koson/LinearPS/LinearPS-BOM.xlsx

Source: | F:\OneDrive\__PCB Works\LinearPS\LinearPS.kicad_sch
Date: | 2021-06-12 21:37
Tool: | Eeschema (5.99.0-10447-gf083f043cb)
Generator: | C:\Program Files\KiCad\5.99\bin\scripting\plugins/bom_csv_grouped_by_value.py
Component Count: | 102
Item | Qty | Reference(s) | Value | LibPart | Footprint | Datasheet | Description | Part_Number
1 | 2 | C1, C10 | CP | LinearPS-rescue:CP | Capacitors_THT:CP_Radial_D18.0mm_P7.50mm | http://www.es.co.th/detail.asp?Prod=056603488 | E-Cap KM Series 4700uF/50Vdc -40 C to +105 C, 20% ,2000hrs. Miniature Sized | EKM478M1HL40RRSAP
2 | 4 | C2, C3, C7, C12 | 47 uF | LinearPS-rescue:CP | Capacitors_THT:CP_Radial_D8.0mm_P5.00mm | http://www.es.co.th/detail.asp?Prod=056601120 | E-Cap GS Series 4.7uF/400Volt | EGS475M2GF12RRSAP
3 | 4 | C4, C13, C14, C16 | 100 nF | LinearPS-rescue:C | Capacitors_THT:C_Disc_D5.0mm_W2.5mm_P5.00mm | http://www.es.co.th/detail.asp?Prod=015800183 | Ceramic Disc Cap 0.1uF/50V, -20/+80% Dia 7.5mm | S104ZYFE072L
4 | 1 | C5 | 220 nF | LinearPS-rescue:C | Capacitors_THT:C_Disc_D5.0mm_W2.5mm_P5.00mm | http://www.es.co.th/detail.asp?Prod=015802865 | Ceramic Disc Cap 0.22uF/50Vdc, -20/+80%,Y5V | S224ZYFE082LF
5 | 3 | C6, C9, C15 | 100 pF | LinearPS-rescue:C | Capacitors_THT:C_Disc_D5.0mm_W2.5mm_P5.00mm | http://www.es.co.th/detail.asp?Prod=015800245 | Ceramic Disc Cap 100pF/50Vdc, 10% | T101KCHE062L
6 | 1 | C8 | 330 pF | LinearPS-rescue:C | Capacitors_THT:C_Disc_D5.0mm_W2.5mm_P5.00mm | http://www.es.co.th/detail.asp?Prod=015802125 | Ceramic Disc Cap 330pF/50Vdc, 10% | H331KYAE052A-T
7 | 4 | D1, D2, D3, D4 | 10A10 | LinearPS-rescue:D | Diodes_THT:D_P600_R-6_P12.70mm_Horizontal
8 | 5 | D5, D6, D7, D9, D23 | 1N4148 | LinearPS-rescue:D | Diodes_THT:D_DO-35_SOD27_P7.62mm_Horizontal | http://www.es.co.th/detail.asp?Prod=029901371 | Fast Switching Diodes 100V/200mA trr 4ns | PH1N4148TB
9 | 1 | D8 | 1N5339B | LinearPS-rescue:D_Zener | Diodes_THT:D_DO-41_SOD81_P7.62mm_Horizontal | http://www.es.co.th/detail.asp?Prod=013500933 | ZENER DIODE 5.6V/1.3W, Iz=45mA | 1N4734A-TAP
10 | 1 | D10 | 1N4740A | LinearPS-rescue:D_Zener | Diodes_THT:D_DO-41_SOD81_P7.62mm_Horizontal | http://www.es.co.th/detail.asp?Prod=029900847 | Zener Diodes 1W/10V , Iz= 25mA Hermetically Sealed Glass Zener Voltage Regulator | 1N4740ATA-TC/ON
11 | 1 | D11 | 1N4004 | LinearPS-rescue:D | Diodes_THT:D_DO-41_SOD81_P7.62mm_Horizontal | http://www.es.co.th/detail.asp?Prod=030800029 | Silicon Rectifiers Diode 400V/1A | 1N4004-JJ
12 | 2 | D12, D21 | LED | LinearPS-rescue:LED | LEDs:LED_D3.0mm | http://www.es.co.th/detail.asp?Prod=001000491 | LED Round 3mm,4mcd,Red Color Red Diffused Lens | TOL-30BHRADAA
13 | 1 | D22 | 1N4733A | LinearPS-rescue:D_Zener | Diodes_THT:D_DO-41_SOD81_P7.62mm_Horizontal | http://www.es.co.th/detail.asp?prod=029900727 | Zener Diodes 1W/5.1V, Iz = 49mA Hermetically Sealed Glass Zener Voltage Regulator | 1N4733ATA-TC/ON
14 | 1 | J1 | Conn_01x03 | LinearPS-rescue:Conn_01x03 | Connectors_Terminal_Blocks:TerminalBlock_bornier-3_P5.08mm
15 | 1 | J2 | Conn_01x02 | LinearPS-rescue:Conn_01x02 | Connectors_Terminal_Blocks:TerminalBlock_bornier-2_P5.08mm
16 | 2 | J3, J9 | Conn_01x04 | LinearPS-rescue:Conn_01x04 | Connectors_Molex:Molex_KK-6410-04_04x2.54mm_Straight
17 | 8 | J4, J5, J6, J7, J10, J11, J12, J14 | Conn_01x01 | LinearPS-rescue:Conn_01x01 | Connectors:1pin
18 | 1 | J8 | Conn_01x02 | LinearPS-rescue:Conn_01x02 | Connectors_Molex:Molex_KK-6410-02_02x2.54mm_Straight
19 | 3 | JP1, JP2, JP3 | Jumper_NO_Small | LinearPS-rescue:Jumper_NO_Small | Pin_Headers:Pin_Header_Straight_1x02_Pitch2.54mm
20 | 2 | JP4, JP5 | Jumper_NC_Dual | LinearPS-rescue:Jumper_NC_Dual | Pin_Headers:Pin_Header_Straight_1x03_Pitch2.54mm
21 | 1 | Q1 | 2N3904 | LinearPS-rescue:2N3904 | TO_SOT_Packages_THT:TO-92_Molded_Narrow | http://www.es.co.th/detail.asp?prod=012302944 | Transistor NPN 40V/0.2A,for General Purpose Amplifier and Switch, Useful Dynamic Range Extends to 100mA(Switch) and to 100MHz(Amplifier) | 2N3904TA
22 | 1 | Q2 | TIP41 | LinearPS-rescue:TIP41 | linearps:TO-220-3_Vertical_WithPads | http://www.es.co.th/detail.asp?prod=008304245 | Silicon Power Transistors NPN 100V/6A Medium Power Linear and Switching Applications Complementary with TIP42C | TIP41C
23 | 1 | Q3 | 2N3906 | LinearPS-rescue:2N3906 | TO_SOT_Packages_THT:TO-92_Molded_Narrow | http://www.es.co.th/detail.asp?Prod=012302600 | Transistor PNP 40V/0.2A for General Purpose Amplifier and Switching Application at Collector Currents of 10uA to 100mA | 2N3906TA
24 | 4 | Q4, Q5, Q6, Q7 | TIP41 | LinearPS-rescue:TIP41 | linearps:TO-220-3_Vertical_WithBigPads | http://www.es.co.th/detail.asp?prod=008304245 | Silicon Power Transistors NPN 100V/6A Medium Power Linear and Switching Applications Complementary with TIP42C | TIP41C
25 | 4 | R1, R9, R19, R30 | 2k2 | LinearPS-rescue:R | Resistors_THT:R_Axial_DIN0207_L6.3mm_D2.5mm_P7.62mm_Horizontal |  |  | R 2k2 1/4W 5%
26 | 1 | R2 | 82R | LinearPS-rescue:R | Resistors_THT:R_Axial_DIN0411_L9.9mm_D3.6mm_P12.70mm_Horizontal |  |  | R 82E 1W 5%
27 | 1 | R3 | 220R | LinearPS-rescue:R | Resistors_THT:R_Axial_DIN0411_L9.9mm_D3.6mm_P12.70mm_Horizontal |  |  | R 220E 1W 5%
28 | 1 | R4 | 4k7 | LinearPS-rescue:R | Resistors_THT:R_Axial_DIN0207_L6.3mm_D2.5mm_P7.62mm_Horizontal |  |  | R 4k7 1/4W 5%
29 | 10 | R5, R6, R15, R20, R21, R28, R29, R34, R36, R38 | 10k | LinearPS-rescue:R | Resistors_THT:R_Axial_DIN0207_L6.3mm_D2.5mm_P7.62mm_Horizontal |  |  | R 10k 1/4W 5%
30 | 5 | R7, R24, R25, R26, R27 | 0R47 | LinearPS-rescue:R | Resistors_THT:R_Axial_Power_L25.0mm_W6.4mm_P27.94mm |  |  | R 0R47 5W 5%
31 | 2 | R8, R11 | 27k | LinearPS-rescue:R | Resistors_THT:R_Axial_DIN0207_L6.3mm_D2.5mm_P7.62mm_Horizontal |  |  | R 27k 1/4W 5%
32 | 4 | R10, R23, R37, R39 | 100k | LinearPS-rescue:R | Resistors_THT:R_Axial_DIN0207_L6.3mm_D2.5mm_P7.62mm_Horizontal |  |  | R 100k 1/4W 5%
33 | 1 | R12 | 56k | LinearPS-rescue:R | Resistors_THT:R_Axial_DIN0207_L6.3mm_D2.5mm_P7.62mm_Horizontal |  |  | R 56k 1/4W 5%
34 | 1 | R13 | 22k | LinearPS-rescue:R | Resistors_THT:R_Axial_DIN0207_L6.3mm_D2.5mm_P7.62mm_Horizontal |  |  | R 22k 1/4W 5%
35 | 1 | R14 | 1k | LinearPS-rescue:R | Resistors_THT:R_Axial_DIN0207_L6.3mm_D2.5mm_P7.62mm_Horizontal |  |  | R 1k 1/4W 5%
36 | 3 | R16, R32, R33 | 1k | LinearPS-rescue:R | Resistors_THT:R_Axial_DIN0411_L9.9mm_D3.6mm_P12.70mm_Horizontal |  |  | R 1k 1W 5%
37 | 1 | R17 | 33R | LinearPS-rescue:R | Resistors_THT:R_Axial_DIN0207_L6.3mm_D2.5mm_P7.62mm_Horizontal |  |  | R 33R 1/4W 5%
38 | 1 | R18 | 33k | LinearPS-rescue:R | Resistors_THT:R_Axial_DIN0207_L6.3mm_D2.5mm_P7.62mm_Horizontal |  |  | R 33k 1/4W 5%
39 | 2 | R22, R31 | 3k9 | LinearPS-rescue:R | Resistors_THT:R_Axial_DIN0207_L6.3mm_D2.5mm_P7.62mm_Horizontal |  |  | R 3k9 1/4W 5%
40 | 1 | R35 | 1M | LinearPS-rescue:R | Resistors_THT:R_Axial_DIN0207_L6.3mm_D2.5mm_P7.62mm_Horizontal |  |  | R 1M 1/4W 5%
41 | 1 | R40 | 47k | LinearPS-rescue:R | Resistors_THT:R_Axial_DIN0207_L6.3mm_D2.5mm_P7.62mm_Horizontal |  |  | R 47k 1/4W 5%
42 | 2 | RV1, RV2 | 10k | LinearPS-rescue:POT | Potentiometers:Potentiometer_WirePads |  |  | Volume 10kB
43 | 1 | RV3 | 100k | LinearPS-rescue:POT | Potentiometers:Potentiometer_Trimmer_Bourns_3296W | http://www.es.co.th/detail.asp?prod=014102719 | Trimpot 25 Turns,100k, 10%, 0.5 w. | 3296W-1-104LF
44 | 1 | RV6 | 20k | LinearPS-rescue:POT | Potentiometers:Potentiometer_Trimmer_Bourns_3296W | http://www.es.co.th/detail.asp?prod=014102631 | Trimpot 25 Turns,20k,10%, 0.5 w. | 3296W-1-203LF
45 | 3 | U1, U2, U3 | LM358 | LinearPS-rescue:LM358 | Housings_DIP:DIP-8_W7.62mm_Socket | http://www.es.co.th/detail.asp?Prod=008607238 | Dual Op-Amp,Unity Gain Bandwidth 700kHz Slew Rate 0.3V/us,Input Offset Voltage 3mV Single Supply 3V-32V,Dual Supply ±1.5V to ±16V | LM358P
