koson/LinearPS/LinearPS.kicad_pcb

## KiCad design LinearPS.kicad_pcb (2021-05-29)

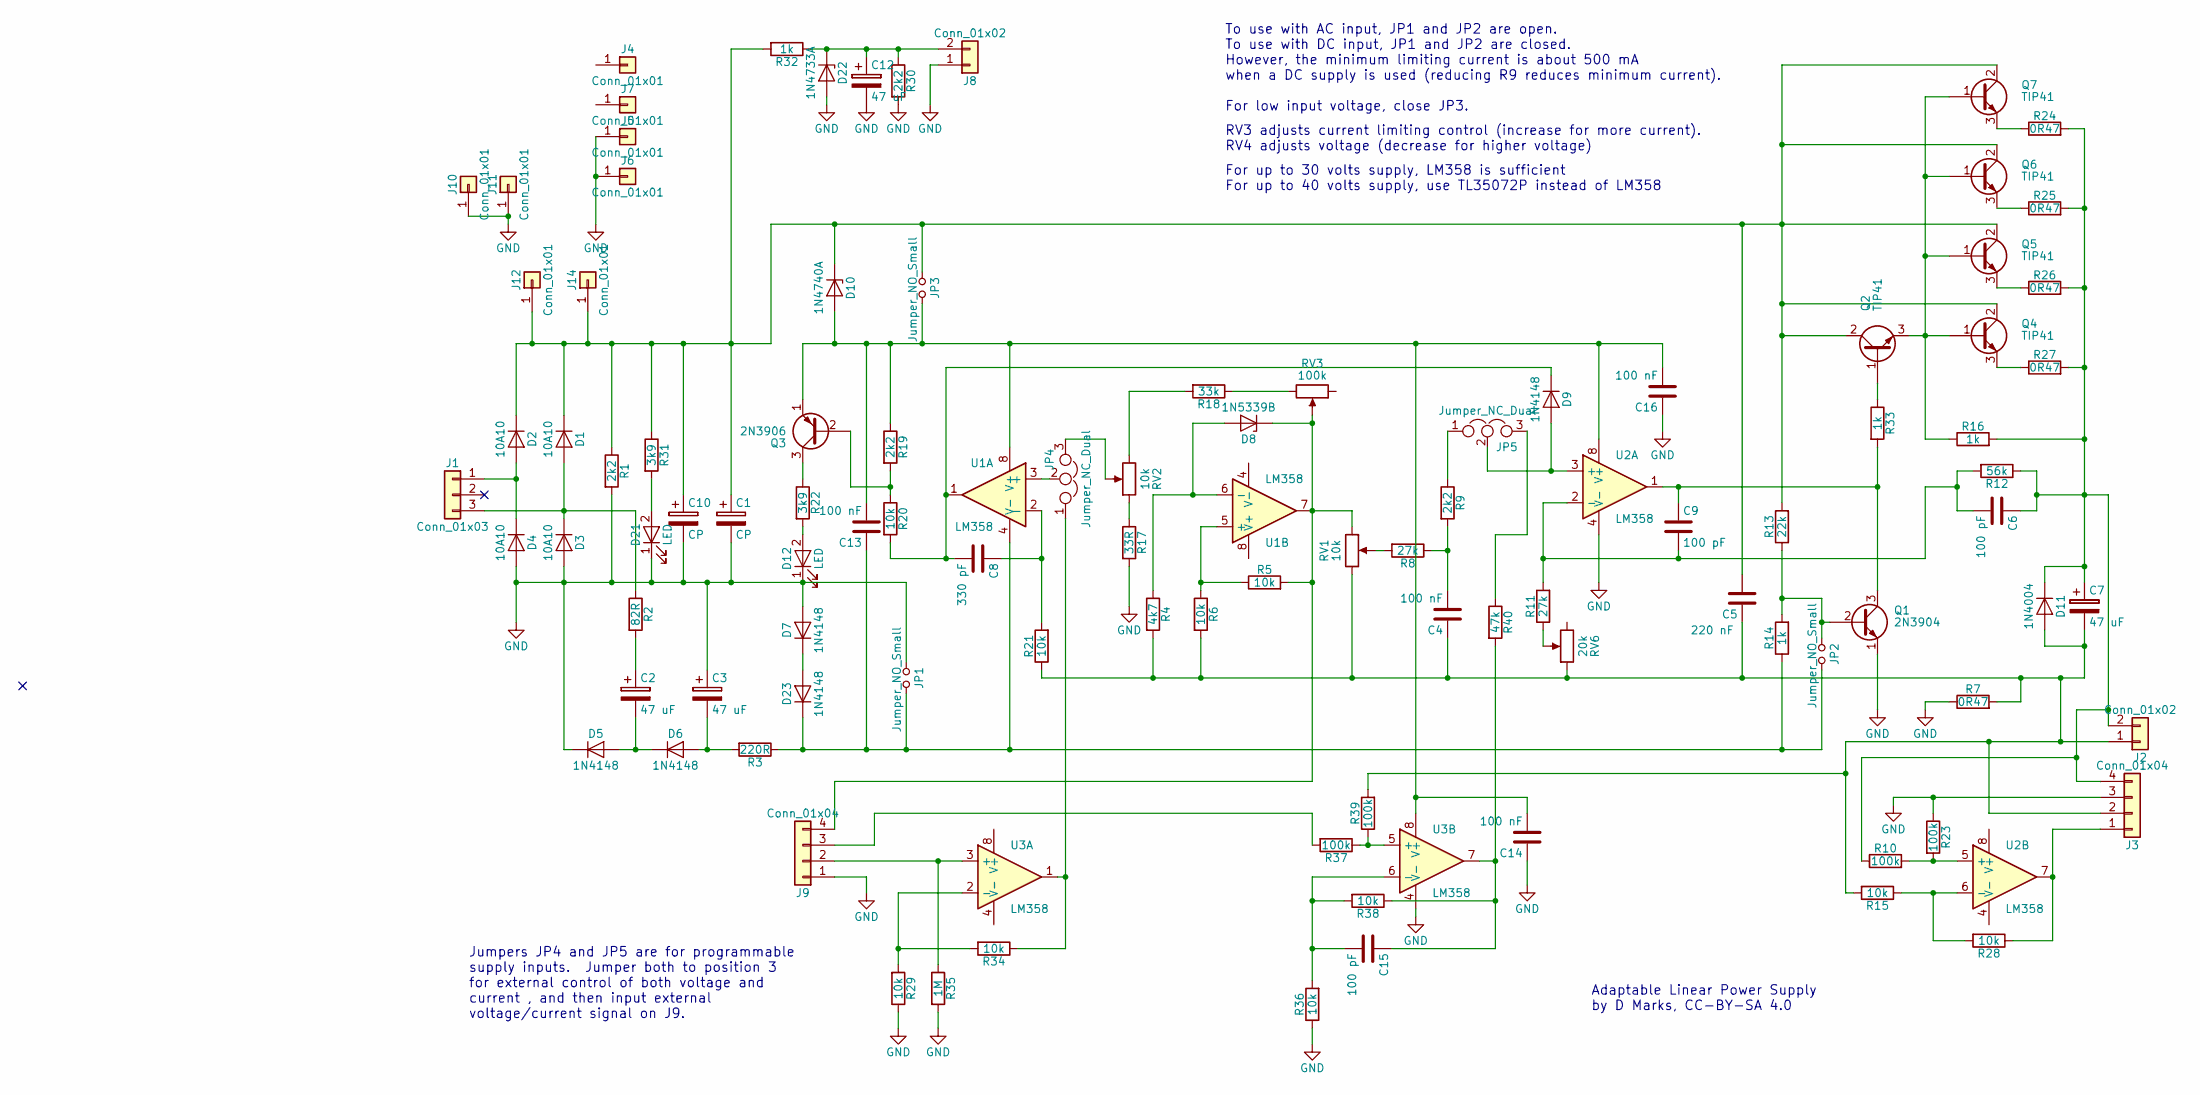
[picture p1: schematic LinearPS.kicad_sch]

Parts:
C1, C10: CP; CP_Radial_D18.0mm_P7.50mm
C2, C3, C7, C12: 47 uF; CP_Radial_D8.0mm_P5.00mm
C4, C13, C14, C16: 100 nF; C_Disc_D5.0mm_W2.5mm_P5.00mm
C5: 220 nF; C_Disc_D5.0mm_W2.5mm_P5.00mm
C6, C9, C15: 100 pF; C_Disc_D5.0mm_W2.5mm_P5.00mm
C8: 330 pF; C_Disc_D5.0mm_W2.5mm_P5.00mm
D1, D2, D3, D4: 10A10; D_P600_R-6_P12.70mm_Horizontal
D5, D6, D7, D9, D23: 1N4148; D_DO-35_SOD27_P7.62mm_Horizontal
D8: 1N5339B; D_DO-41_SOD81_P7.62mm_Horizontal
D10: 1N4740A; D_DO-41_SOD81_P7.62mm_Horizontal
D11: 1N4004; D_DO-41_SOD81_P7.62mm_Horizontal
D12, D21: LED; LED_D3.0mm
D22: 1N4733A; D_DO-41_SOD81_P7.62mm_Horizontal
J1: Conn_01x03; TerminalBlock_bornier-3_P5.08mm
J2: Conn_01x02; TerminalBlock_bornier-2_P5.08mm
J3, J9: Conn_01x04; Molex_KK-6410-04_04x2.54mm_Straight
J4, J5, J6, J7, J10, J11, J12, J14: Conn_01x01; 1pin
J8: Conn_01x02; Molex_KK-6410-02_02x2.54mm_Straight
JP1, JP2, JP3: Jumper_NO_Small; Pin_Header_Straight_1x02_Pitch2.54mm
JP4, JP5: Jumper_NC_Dual; Pin_Header_Straight_1x03_Pitch2.54mm
Q1: 2N3904; TO-92_Molded_Narrow
Q2: TIP41; TO-220-3_Vertical_WithPads
Q3: 2N3906; TO-92_Molded_Narrow
Q4, Q5, Q6, Q7: TIP41; TO-220-3_Vertical_WithBigPads
R1, R9, R19, R30: 2k2; R_Axial_DIN0207_L6.3mm_D2.5mm_P7.62mm_Horizontal
R2: 82R; R_Axial_DIN0411_L9.9mm_D3.6mm_P12.70mm_Horizontal
R3: 220R; R_Axial_DIN0411_L9.9mm_D3.6mm_P12.70mm_Horizontal
R4: 4k7; R_Axial_DIN0207_L6.3mm_D2.5mm_P7.62mm_Horizontal
R5, R6, R15, R20, R21, R28, R29, R34, R36, R38: 10k; R_Axial_DIN0207_L6.3mm_D2.5mm_P7.62mm_Horizontal
R7, R24, R25, R26, R27: 0R47; R_Axial_Power_L25.0mm_W6.4mm_P27.94mm
R8, R11: 27k; R_Axial_DIN0207_L6.3mm_D2.5mm_P7.62mm_Horizontal
R10, R23, R37, R39: 100k; R_Axial_DIN0207_L6.3mm_D2.5mm_P7.62mm_Horizontal
R12: 56k; R_Axial_DIN0207_L6.3mm_D2.5mm_P7.62mm_Horizontal
R13: 22k; R_Axial_DIN0207_L6.3mm_D2.5mm_P7.62mm_Horizontal
R14: 1k; R_Axial_DIN0207_L6.3mm_D2.5mm_P7.62mm_Horizontal
R16, R32, R33: 1k; R_Axial_DIN0411_L9.9mm_D3.6mm_P12.70mm_Horizontal
R17: 33R; R_Axial_DIN0207_L6.3mm_D2.5mm_P7.62mm_Horizontal
R18: 33k; R_Axial_DIN0207_L6.3mm_D2.5mm_P7.62mm_Horizontal
R22, R31: 3k9; R_Axial_DIN0207_L6.3mm_D2.5mm_P7.62mm_Horizontal
R35: 1M; R_Axial_DIN0207_L6.3mm_D2.5mm_P7.62mm_Horizontal
R40: 47k; R_Axial_DIN0207_L6.3mm_D2.5mm_P7.62mm_Horizontal
RV1, RV2: 10k; Potentiometer_WirePads
RV3: 100k; Potentiometer_Trimmer_Bourns_3296W
RV6: 20k; Potentiometer_Trimmer_Bourns_3296W
U1, U2, U3: LM358; DIP-8_W7.62mm_Socket

Connections:
GND: C1.2, C3.1, C10.2, C12.2, C14.1, C16.1, D3.2 (A), D4.2 (A), D5.1 (K), D7.2 (A), D12.1 (K), D21.1 (K), D22.2 (A), J3.3, J5.1, J6.1, J8.1, J9.1, J10.1, J11.1, JP1.1, Q1.1 (E), R1.2, R7.1, R17.2, R23.1, R29.1, R30.2, R35.2, R36.1, U2.4 (V-), U3.4 (V-)
unnamed: C1.1, C5.2, C10.1, D1.1 (K), D2.1 (K), D10.1 (K), J12.1, J14.1, JP3.1, Q2.2 (C), Q4.2 (C), Q5.2 (C), Q6.2 (C), Q7.2 (C), R1.1, R13.2, R31.1, R32.2
unnamed: C2.1, R2.2
unnamed: C2.2, D5.2 (A), D6.1 (K)
unnamed: C3.2, D6.2 (A), R3.2
unnamed: C4.1, C5.1, C7.2, D11.2 (A), J2.1, J3.2, R4.2, R6.2, R7.2, R15.2, R21.1, R39.2, RV1.3, RV6.1
unnamed: C4.2, R8.1, R9.2
unnamed: C6.1, C7.1, D11.1 (K), J2.2, J3.4, R10.1, R12.1, R16.2, R24.2, R25.2, R26.2, R27.2
unnamed: C6.2, C9.2, R11.2, R12.2, U2.2 (-)
unnamed: C8.1, R21.2, U1.2 (-)
unnamed: C8.2, D9.1 (K), R20.2, U1.1
unnamed: C9.1, Q1.3 (C), R33.2, U2.1
unnamed: C12.1, D22.1 (K), J8.2, R30.1, R32.1
unnamed: C13.1, D23.1 (K), JP1.2, JP2.2, R3.1, R14.1, U1.4 (V-)
unnamed: C13.2, C14.2, C16.2, D10.2 (A), JP3.2, Q3.1 (E), R19.1, U1.8 (V+), U2.8 (V+), U3.8 (V+)
unnamed: C15.1, R38.1, R40.2, U3.7
unnamed: C15.2, R36.2, R38.2, U3.6 (-)
unnamed: D1.2 (A), D3.1 (K), J1.3, R2.1
unnamed: D2.2 (A), D4.1 (K), J1.1
unnamed: D8.1 (K), J9.4, R5.2, RV1.1, RV3.2, U1.7
unnamed: D8.2 (A), R4.1, U1.6 (-)
unnamed: D9.2 (A), JP5.2, U2.3 (+)
unnamed: D12.2 (A), R22.2
unnamed: D21.2 (A), R31.2
unnamed: D7.1 (K), D23.2 (A)
unnamed: J3.1, R28.1, U2.7
unnamed: J9.2, R35.1, U3.3 (+)
unnamed: J9.3, R37.2
unnamed: JP2.1, Q1.2 (B), R13.1, R14.2
unnamed: JP4.1, R34.1, U3.1
unnamed: JP4.2, U1.3 (+)
unnamed: JP4.3, RV2.2
unnamed: JP5.1, R9.1
unnamed: JP5.3, R40.1
unnamed: Q2.1 (B), R33.1
unnamed: Q2.3 (E), Q4.1 (B), Q5.1 (B), Q6.1 (B), Q7.1 (B), R16.1
unnamed: Q3.2 (B), R19.2, R20.1
unnamed: Q3.3 (C), R22.1
unnamed: Q4.3 (E), R27.1
unnamed: Q5.3 (E), R26.1
unnamed: Q6.3 (E), R25.1
unnamed: Q7.3 (E), R24.1
unnamed: R5.1, R6.1, U1.5 (+)
unnamed: R8.2, RV1.2
unnamed: R10.2, R23.2, U2.5 (+)
unnamed: R11.1, RV6.2
unnamed: R15.1, R28.2, U2.6 (-)
unnamed: R17.1, RV2.1
unnamed: R18.1, RV3.3
unnamed: R18.2, RV2.3
unnamed: R29.2, R34.2, U3.2 (-)
unnamed: R37.1, R39.1, U3.5 (+)

Notes on the sheet:
Jumpers JP4 and JP5 are for programmable supply inputs. Jumper both to position 3 for external control of both voltage and current , and then input external voltage/current signal on J9.
To use with AC input, JP1 and JP2 are open. To use with DC input, JP1 and JP2 are closed. However, the minimum limiting current is about 500 mA when a DC supply is used (reducing R9 reduces minimum current). For low input voltage, close JP3.
RV3 adjusts current limiting control (increase for more current). RV4 adjusts voltage (decrease for higher voltage)
For up to 30 volts supply, LM358 is sufficient For up to 40 volts supply, use TL35072P instead of LM358
Adaptable Linear Power Supply by D Marks, CC-BY-SA 4.0

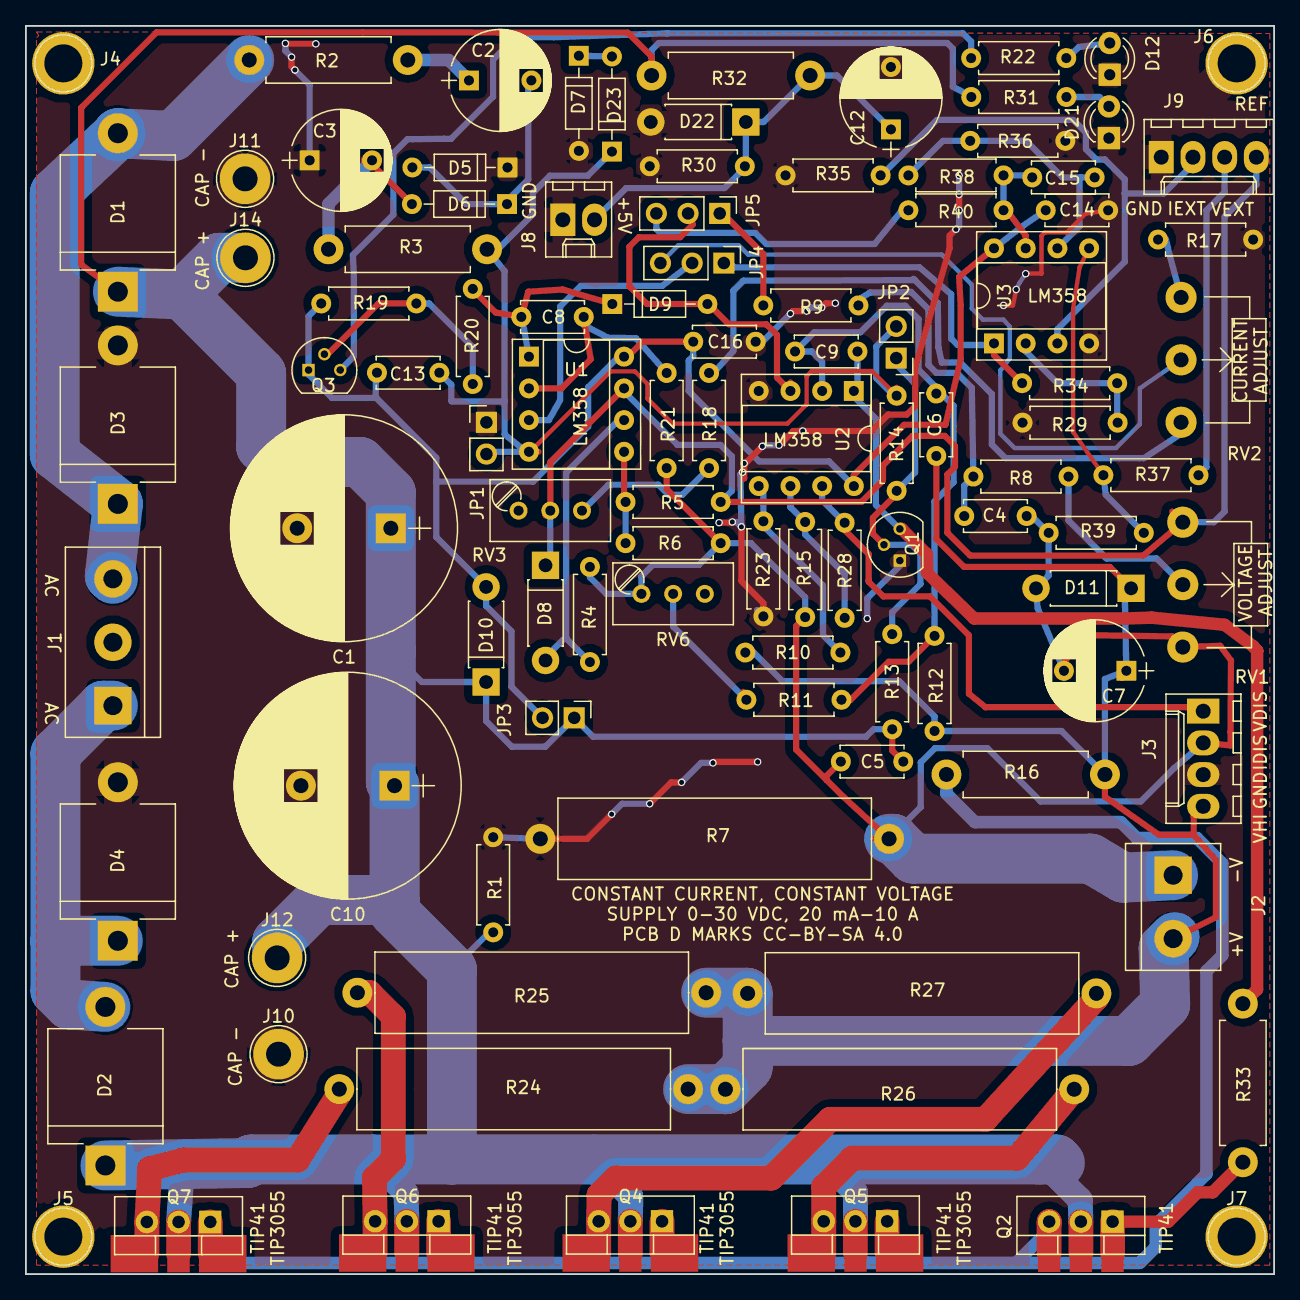
[picture p2: board LinearPS.kicad_pcb from above]

Board: 2 copper layers, 100.0 x 100.0 mm, 102 parts (0 on the bottom side), 52 nets.
