koson/LinearPS/(notices)

Notices in the files:
LinearPS.kicad_pcb:
PCB D MARKS CC-BY-SA 4.0
